DominikMat/String-Art-Robot-V2/raport/traffic-simulator-de-screen.png

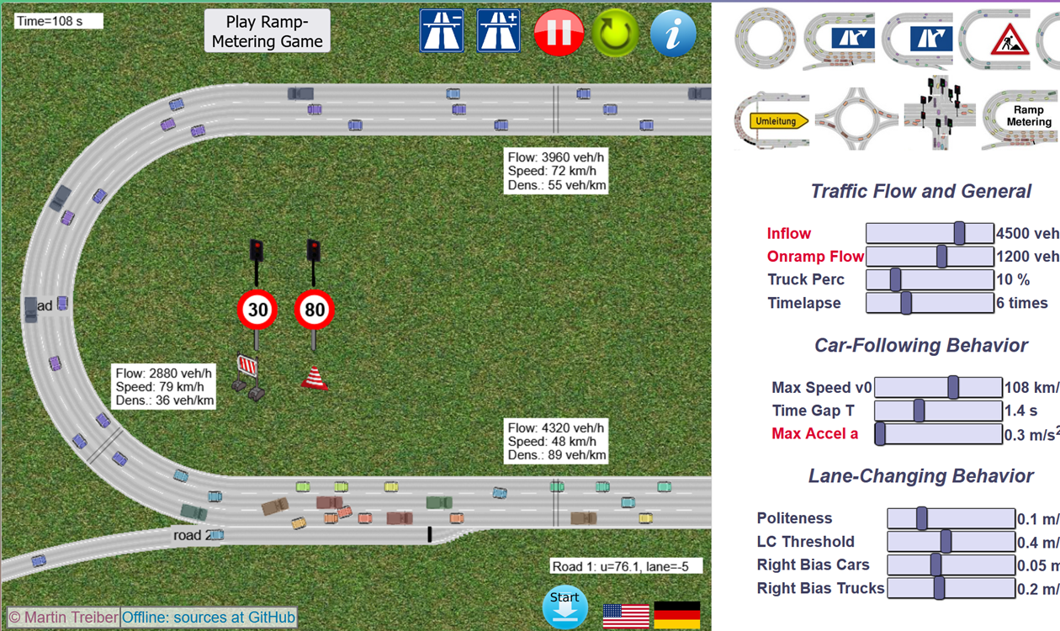
raport/traffic-simulator-de-screen.png
