DominikMat/String-Art-Robot-V2/raport/poczatkowe_szkice.jpg

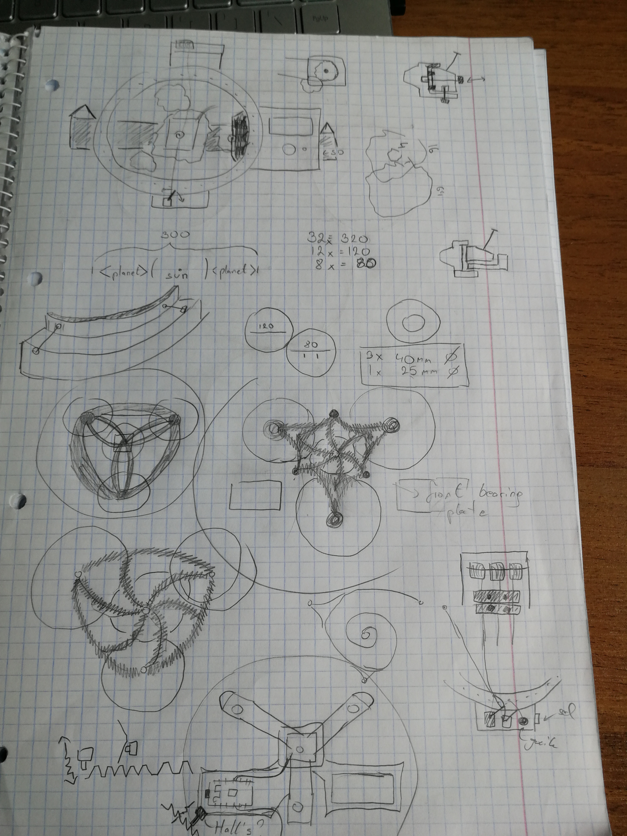
raport/poczatkowe_szkice.jpg
