DominikMat/String-Art-Robot-V2/raport/cad_przekladnia.png

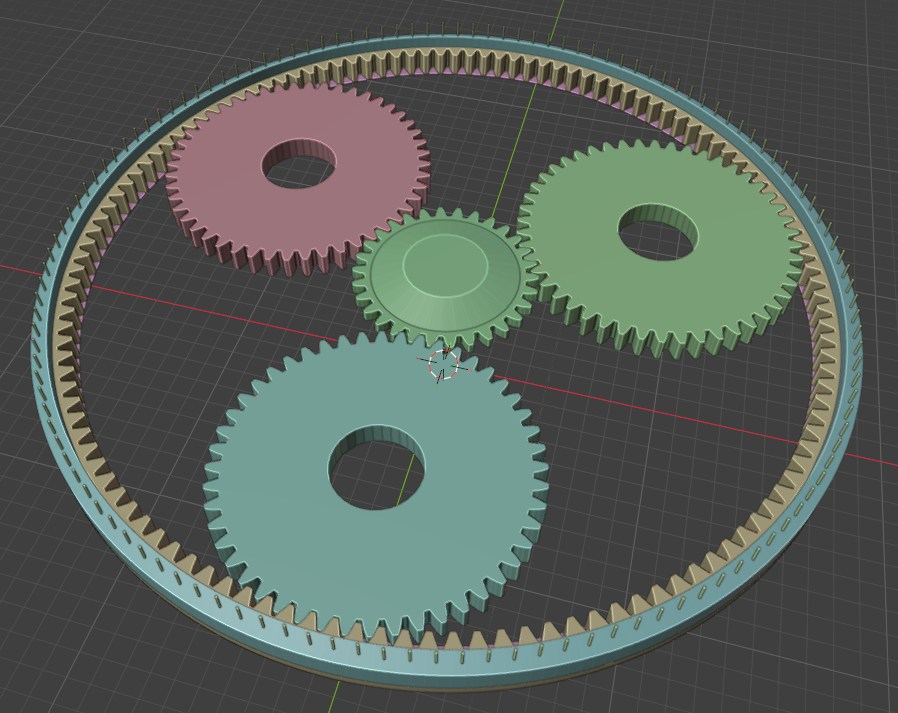
raport/cad_przekladnia.png
