DominikMat/String-Art-Robot-V2/raport/cura_screen_1.png

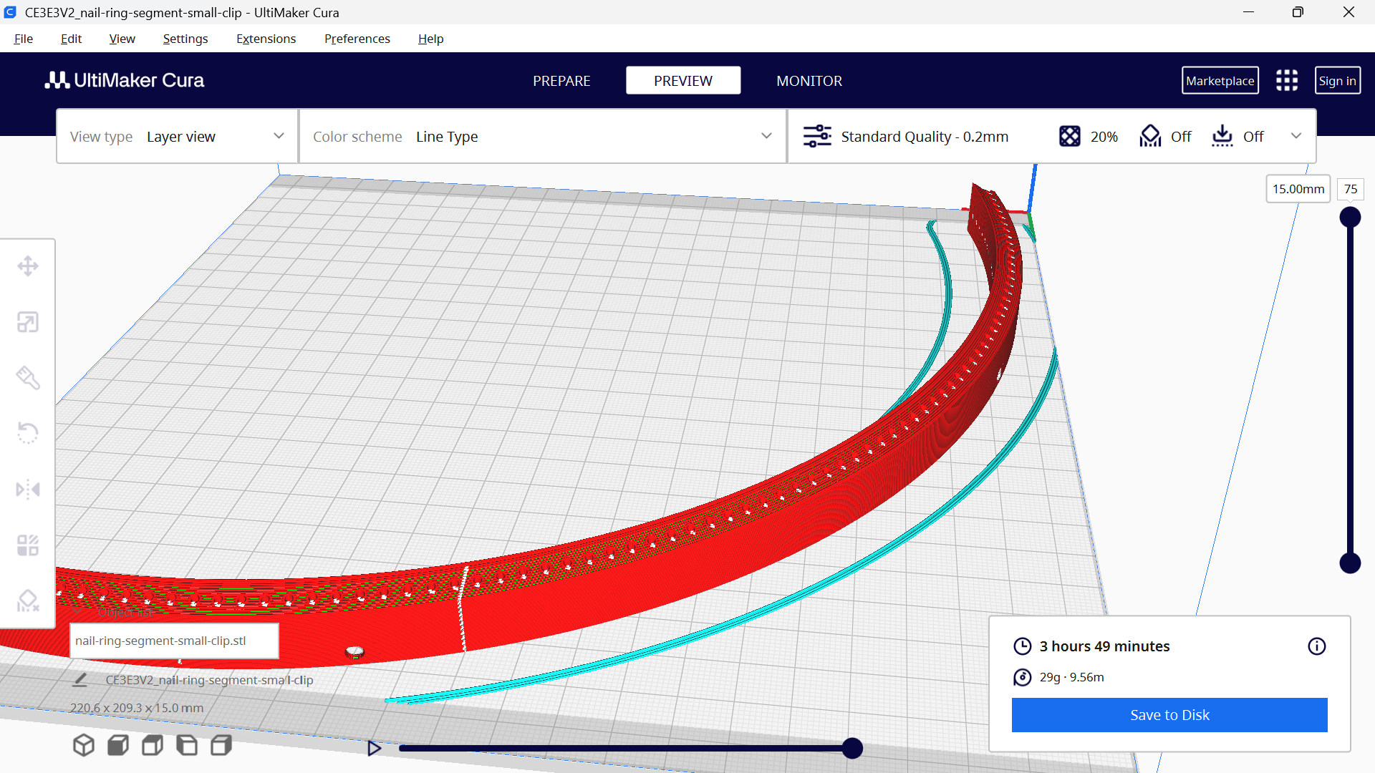
raport/cura_screen_1.png
