DominikMat/String-Art-Robot-V2/raport/dokumentacja_nema.png

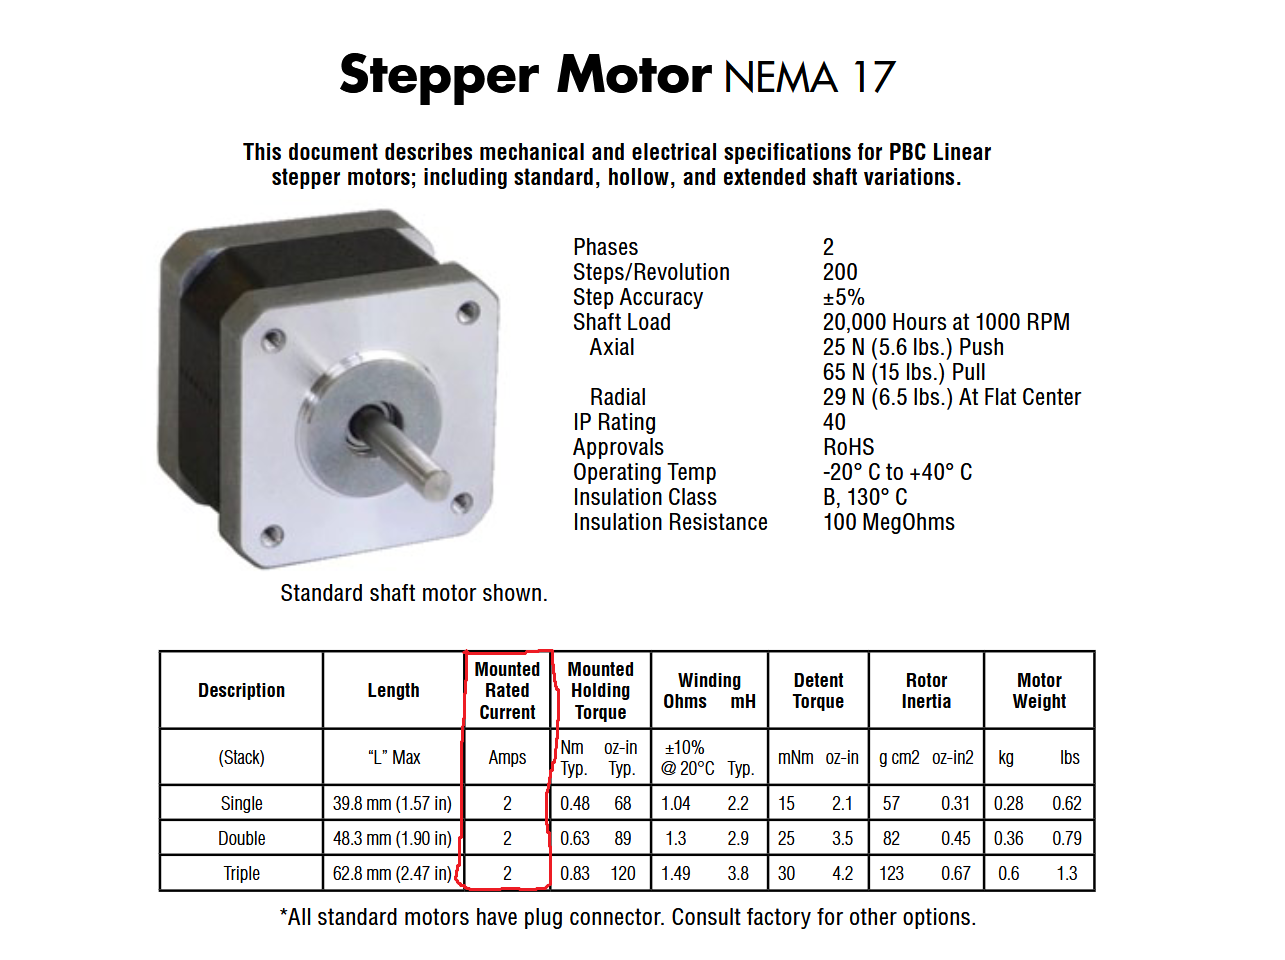
raport/dokumentacja_nema.png
