DominikMat/String-Art-Robot-V2/raport/pattern.png

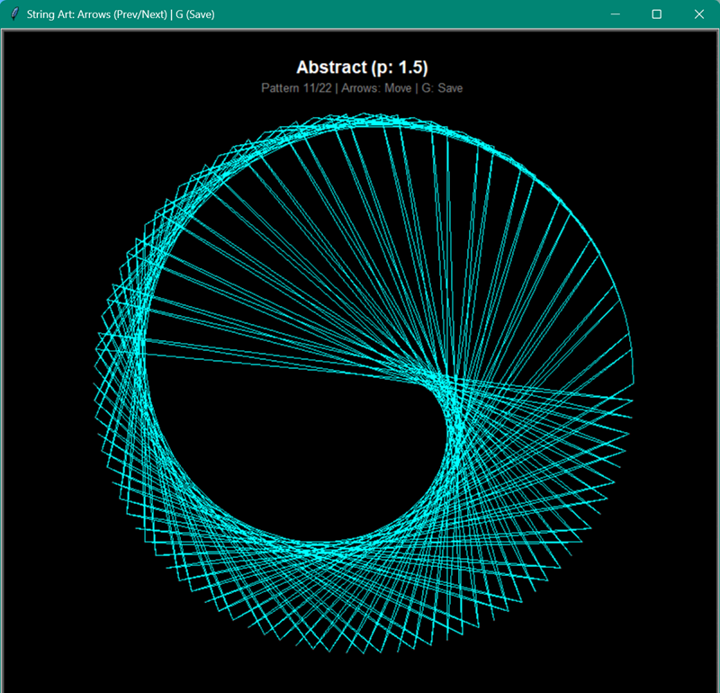
raport/pattern.png
