DominikMat/String-Art-Robot-V2/raport/schemat_ele.png

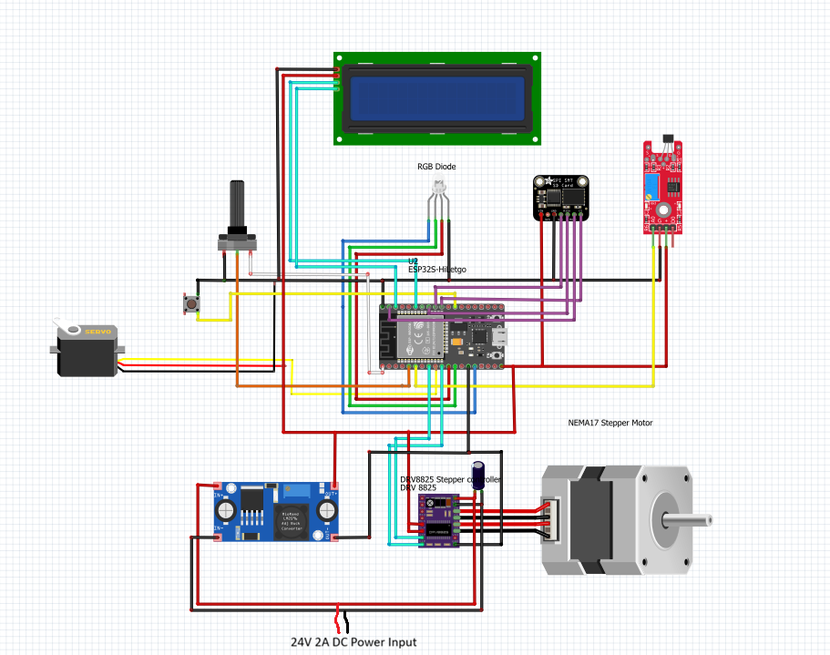
raport/schemat_ele.png
