DominikMat/String-Art-Robot-V2/raport/schemat_przekladnia.png

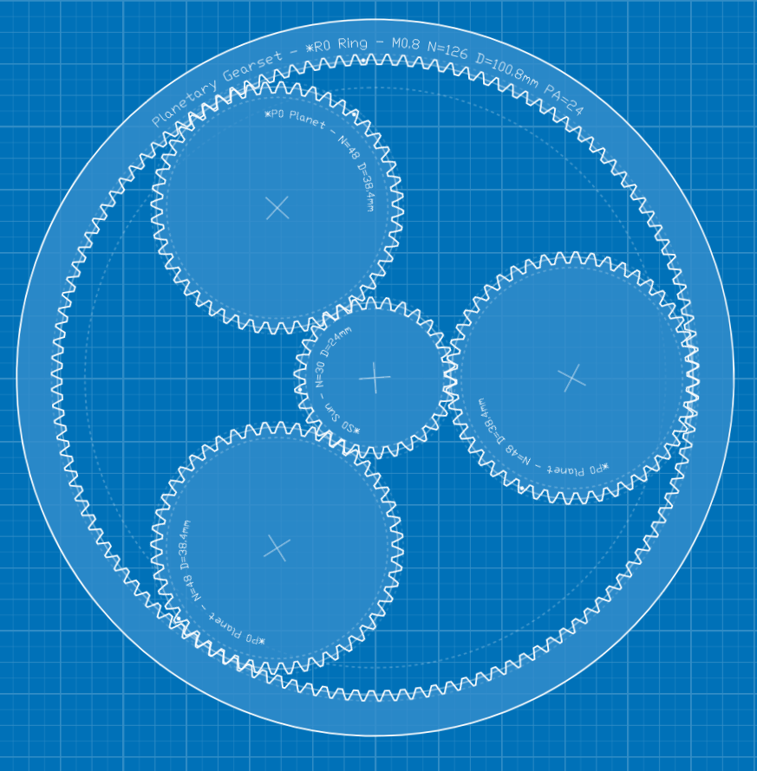
raport/schemat_przekladnia.png
