DominikMat/String-Art-Robot-V2/string_art_robot_pins.png

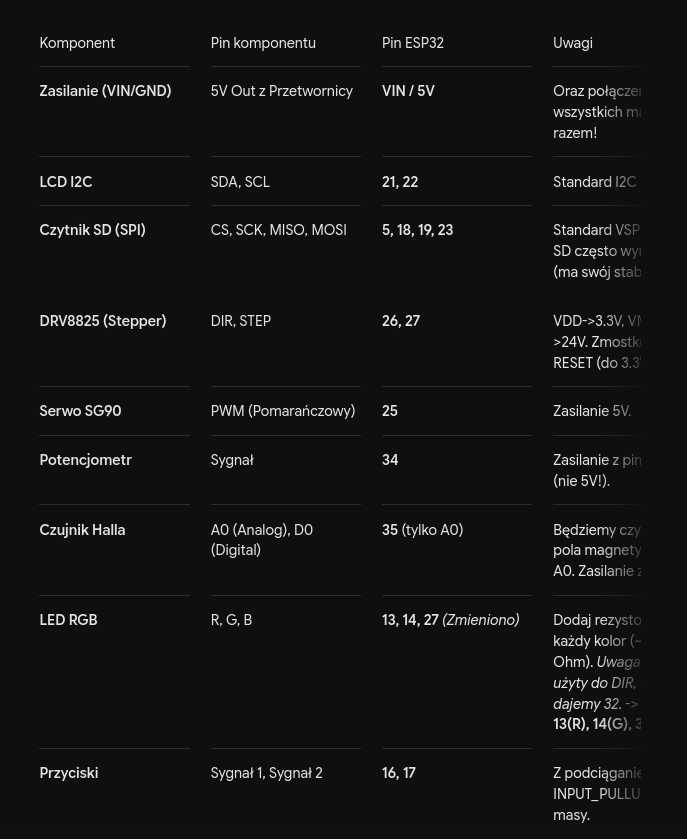
string_art_robot_pins.png
