DominikMat/String-Art-Robot-V2/3d print files/servo-arm.3mf

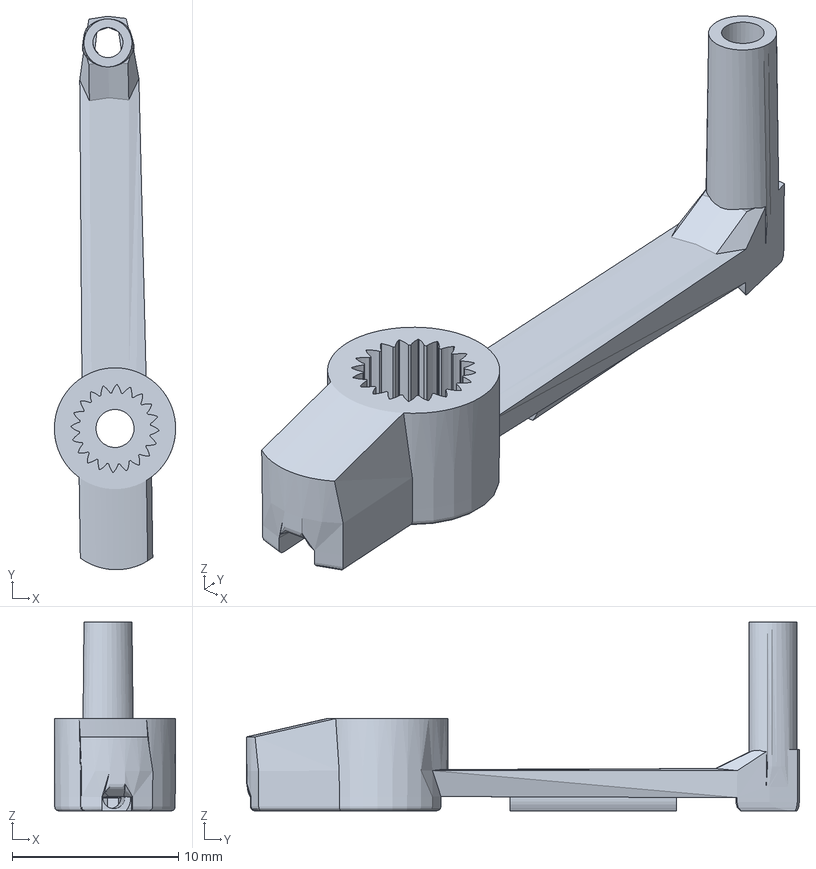
[picture p16: CAD file, 2026-05-09]
3d print files/servo-arm.3mf
7.29 x 33.3 x 11.4 mm
