DominikMat/String-Art-Robot-V2/3d prints V3/external-spool-holder.stl

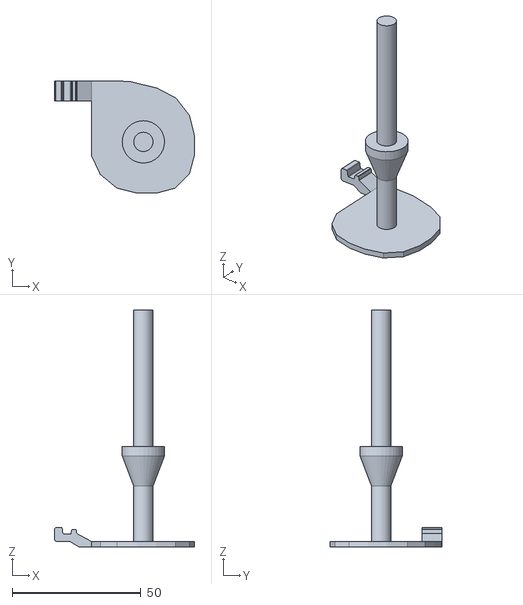
[picture p17: CAD file, 2026-06-16]
3d prints V3/external-spool-holder.stl
54.4 x 43.7 x 92.0
