DominikMat/String-Art-Robot-V2/3d print files/ring-holder-arm-upper.stl

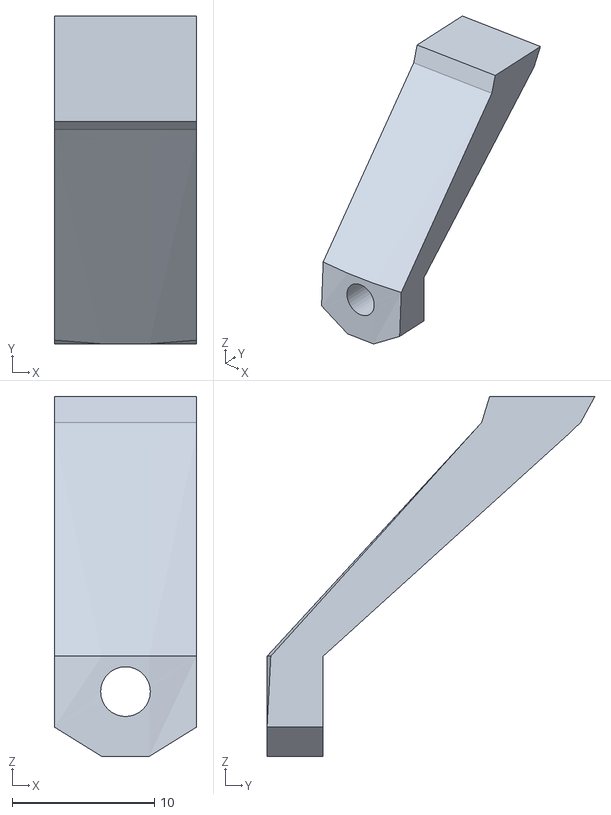
[picture p18: CAD file, 2026-05-09]
3d print files/ring-holder-arm-upper.stl
10.0 x 23.1 x 25.3
