DominikMat/String-Art-Robot-V2/3d prints V3/string-lock.stl

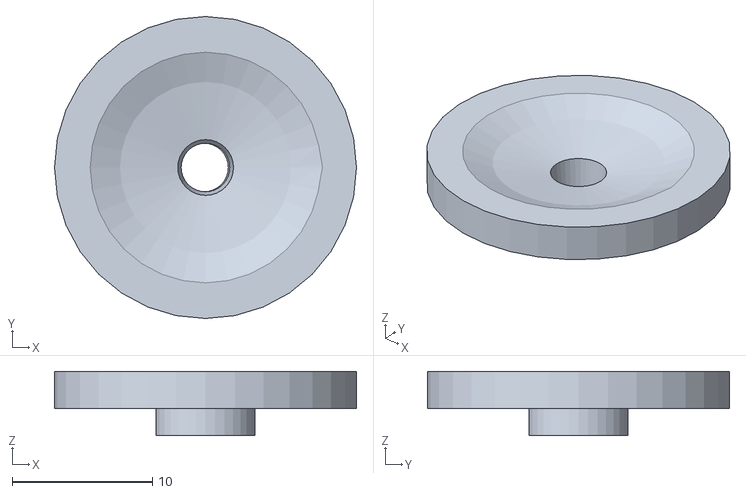
[picture p19: CAD file, 2026-06-10]
3d prints V3/string-lock.stl
21.5 x 21.5 x 4.59
