DominikMat/String-Art-Robot-V2/3d print files/planet-gear-1.stl

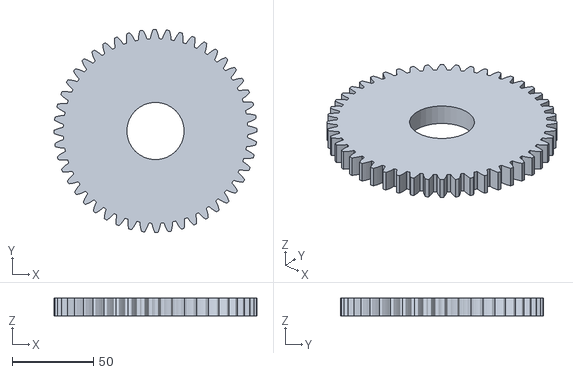
[picture p20: CAD file, 2026-05-09]
3d print files/planet-gear-1.stl
125.0 x 125.0 x 11.0
