DominikMat/String-Art-Robot-V2/3d prints V3/ring-mechanism.3mf

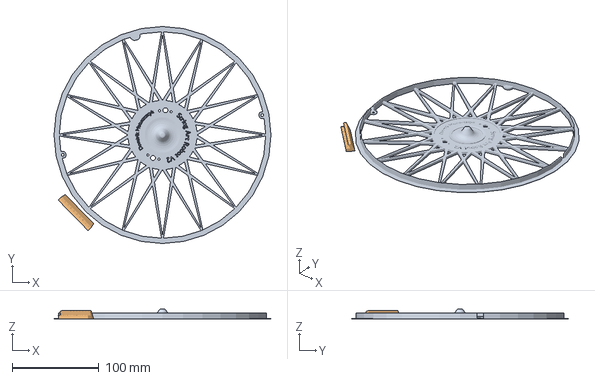
[picture p21: CAD file, 2026-06-10]
3d prints V3/ring-mechanism.3mf
250.0 x 250.0 x 12.0 mm
ring-mechanism.stl
ring-test.stl
