DominikMat/String-Art-Robot-V2/3d print files/nail-ring-segment-small-clip.stl

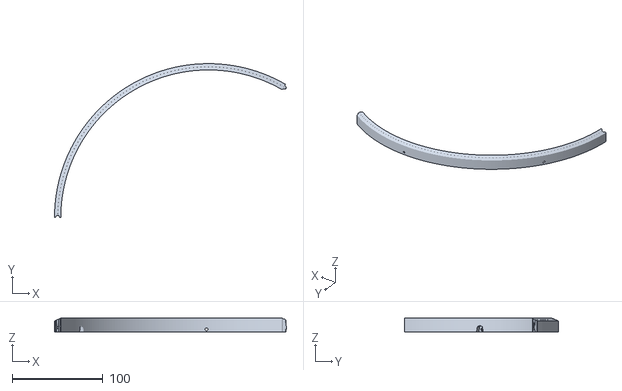
[picture p22: CAD file, 2026-05-09]
3d print files/nail-ring-segment-small-clip.stl
256.2 x 169.8 x 15.0
