DominikMat/String-Art-Robot-V2/3d prints V3/nail-ring.3mf

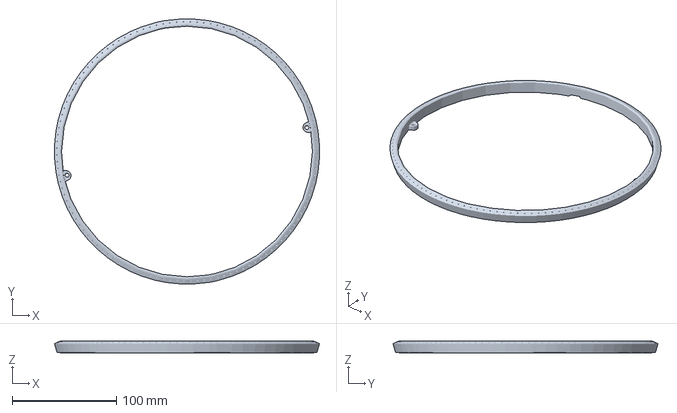
[picture p23: CAD file, 2026-06-10]
3d prints V3/nail-ring.3mf
253.9 x 253.9 x 11.1 mm
