DominikMat/String-Art-Robot-V2/3d print files/ring-holder-arm-lower.stl

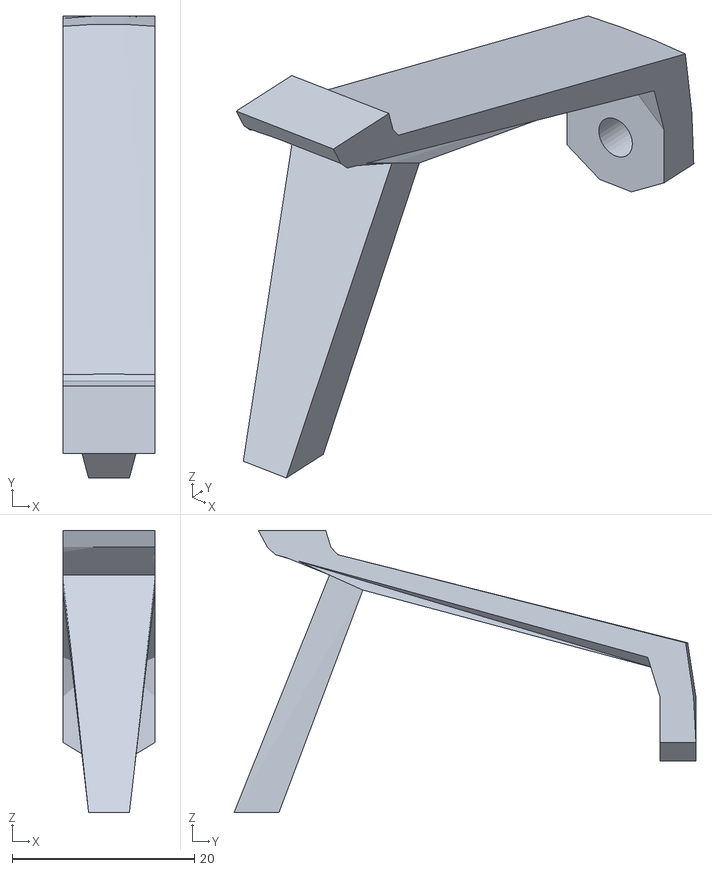
[picture p24: CAD file, 2026-05-09]
3d print files/ring-holder-arm-lower.stl
10.1 x 50.7 x 31.0
