DominikMat/String-Art-Robot-V2/3d prints V3/long-button-cap.3mf

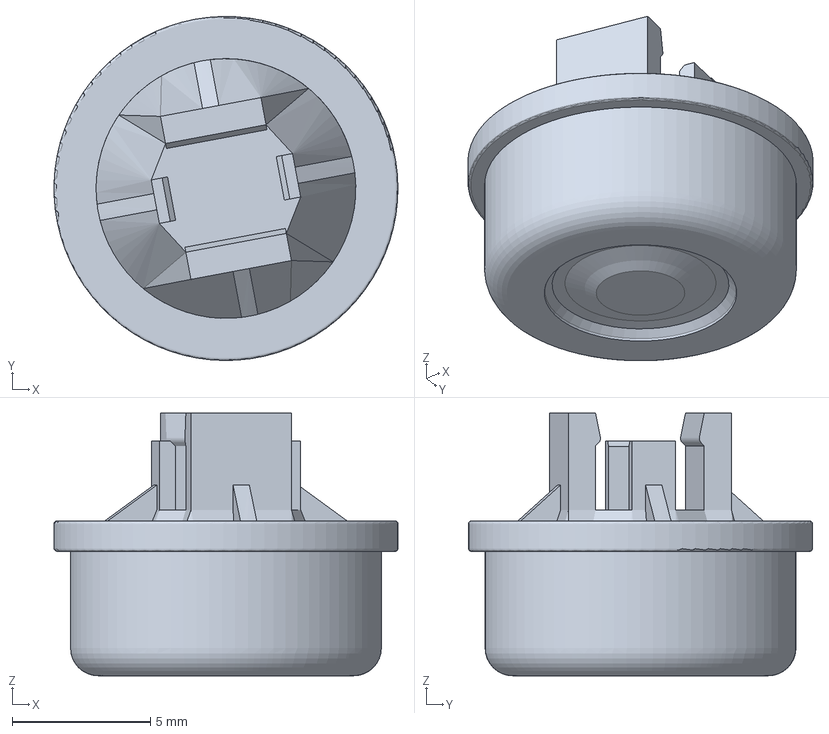
[picture p25: CAD file, 2026-06-10]
3d prints V3/long-button-cap.3mf
12.4 x 12.4 x 9.50 mm
