DominikMat/String-Art-Robot-V2/3d print files/front-plate.stl

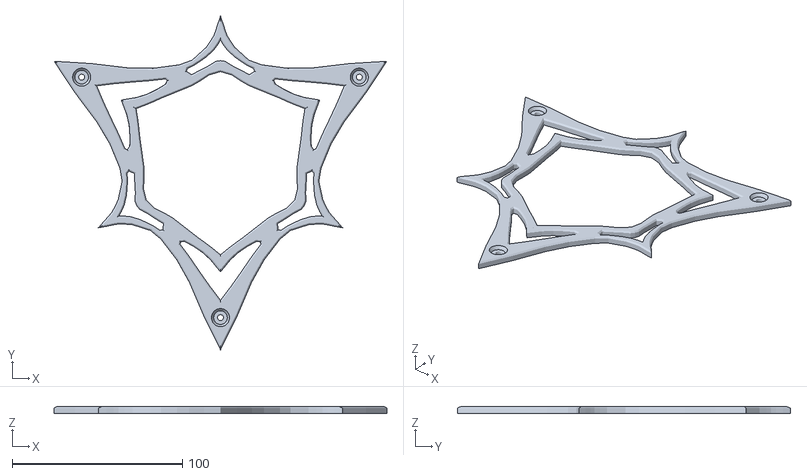
[picture p26: CAD file, 2026-05-09]
3d print files/front-plate.stl
195.7 x 195.8 x 4.00
