DominikMat/String-Art-Robot-V2/3d prints V3/servo-arm-2.3mf

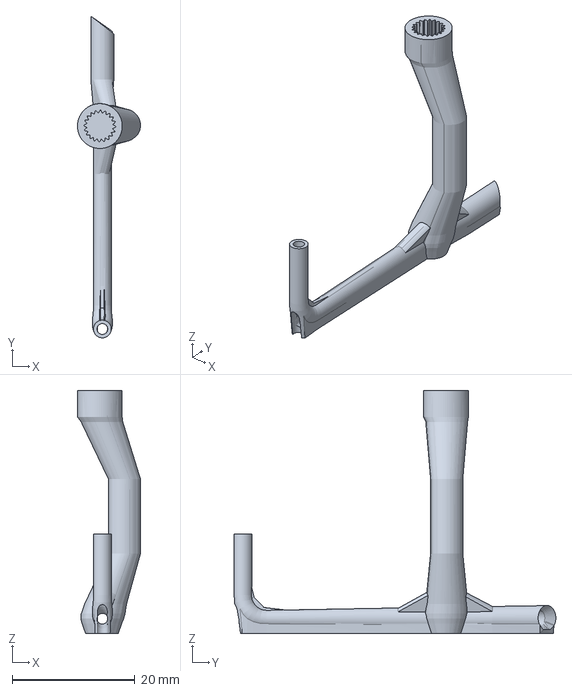
[picture p27: CAD file, 2026-06-10]
3d prints V3/servo-arm-2.3mf
10.3 x 52.4 x 39.6 mm
