DominikMat/String-Art-Robot-V2/3d print files/nail-test-piece.3mf

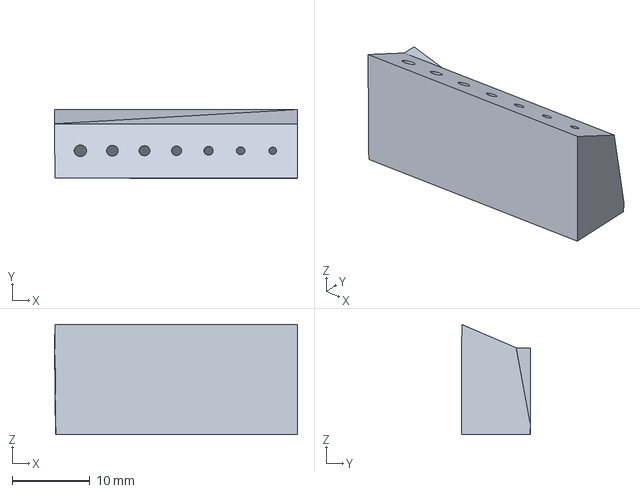
[picture p28: CAD file, 2026-05-09]
3d print files/nail-test-piece.3mf
31.3 x 8.91 x 14.2 mm
