DominikMat/String-Art-Robot-V2/3d prints V3/servo-arm.3mf

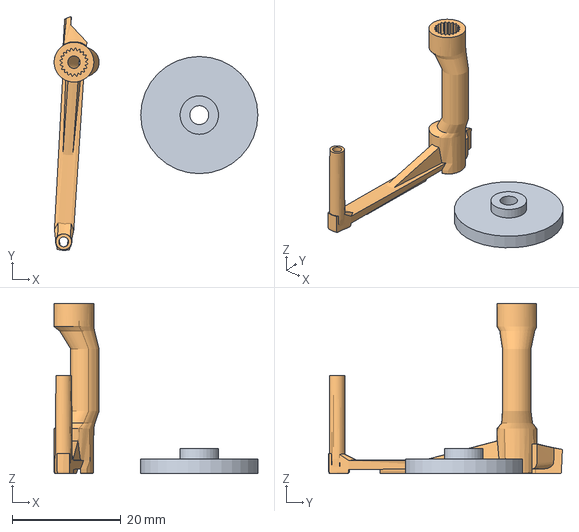
[picture p29: CAD file, 2026-06-10]
3d prints V3/servo-arm.3mf
37.5 x 43.0 x 31.3 mm
string-lock.stl
servo-arm.stl
