DominikMat/String-Art-Robot-V2/3d print files/sun-gear.stl

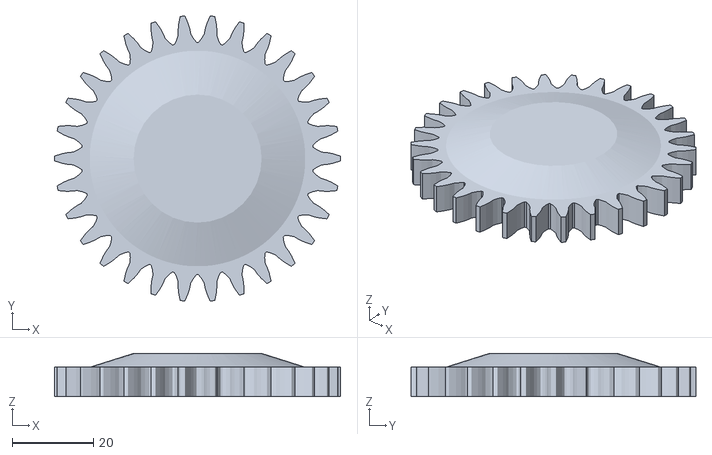
[picture p30: CAD file, 2026-05-09]
3d print files/sun-gear.stl
70.4 x 70.1 x 10.6
