DominikMat/String-Art-Robot-V2/3d prints V3/bottom-stand.3mf

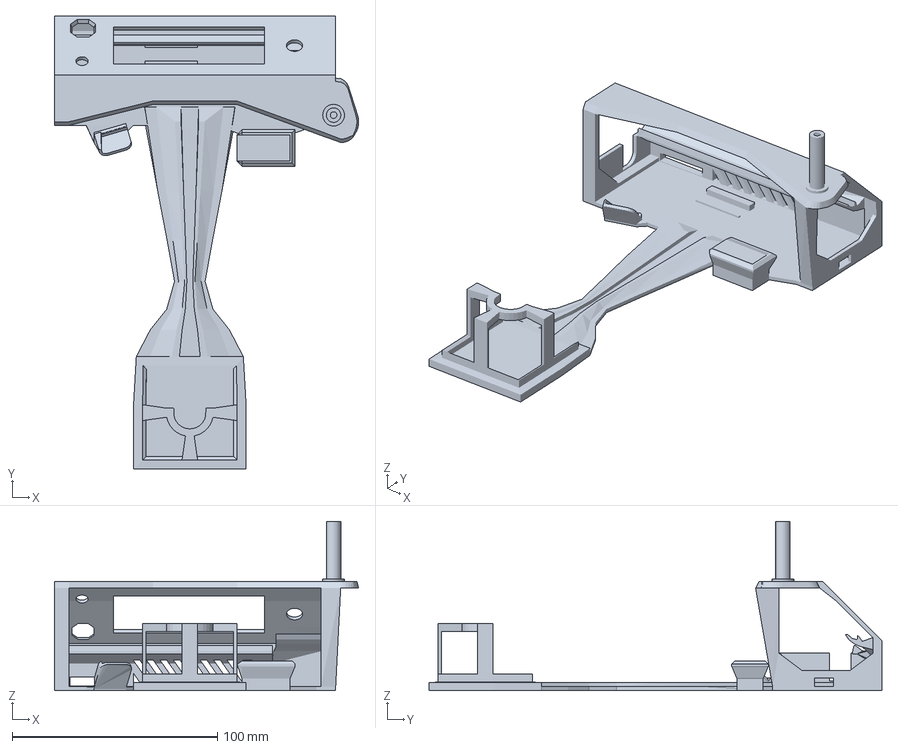
[picture p31: CAD file, 2026-06-10]
3d prints V3/bottom-stand.3mf
148.2 x 220.7 x 82.5 mm
