DominikMat/String-Art-Robot-V2/3d print files/nail-ring-segment.3mf

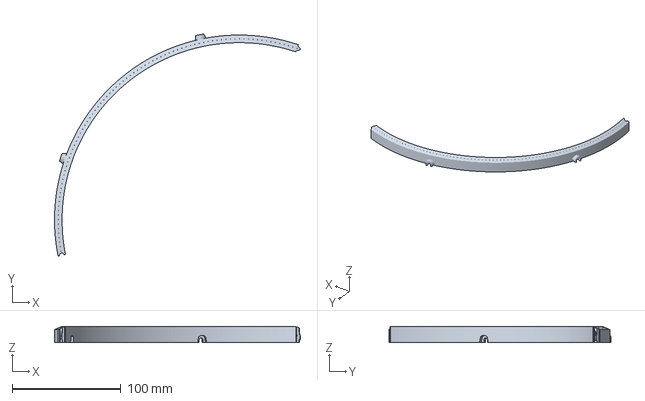
[picture p32: CAD file, 2026-05-09]
3d print files/nail-ring-segment.3mf
226.3 x 204.3 x 15.0 mm
