DominikMat/String-Art-Robot-V2/3d prints V3/ring-test.stl

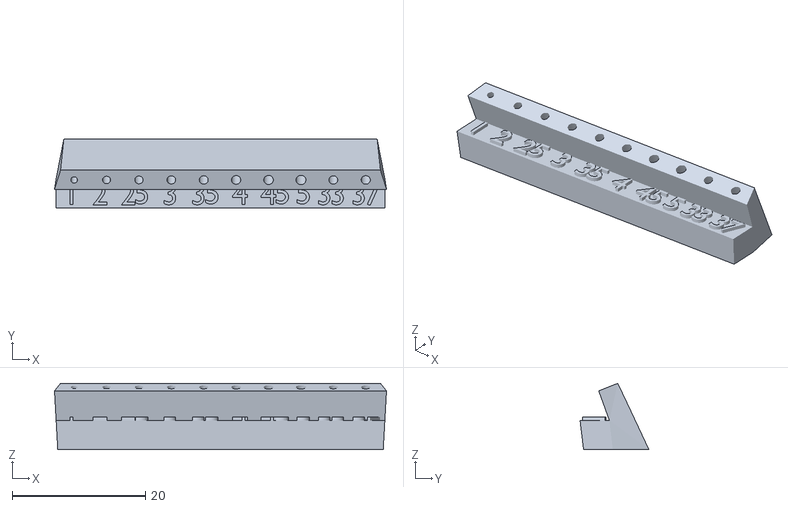
[picture p33: CAD file, 2026-06-10]
3d prints V3/ring-test.stl
49.7 x 10.3 x 9.93
