DominikMat/String-Art-Robot-V2/3d print files/hex-receptor-test-piece.stl

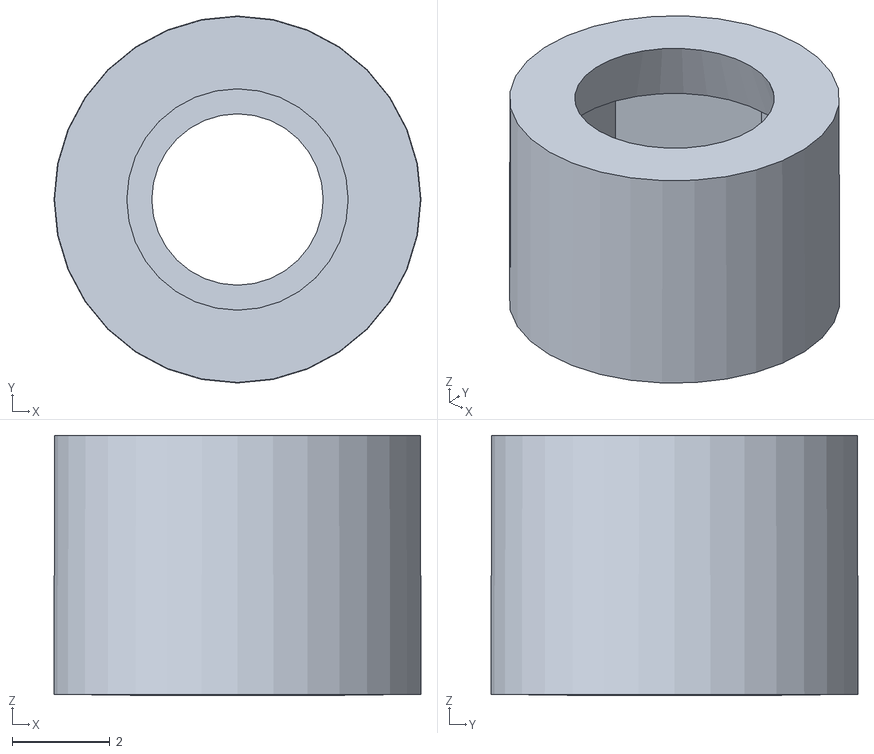
[picture p34: CAD file, 2026-05-09]
3d print files/hex-receptor-test-piece.stl
7.50 x 7.50 x 5.31
