DominikMat/String-Art-Robot-V2/3d prints V3/ring.3mf

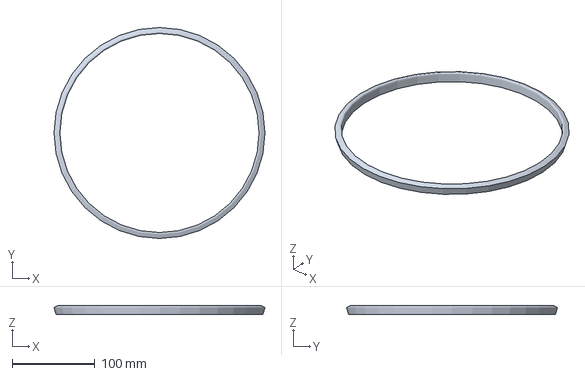
[picture p35: CAD file, 2026-06-10]
3d prints V3/ring.3mf
255.0 x 255.0 x 11.0 mm
