DominikMat/String-Art-Robot-V2/3d print files/ring-gear-segment.stl

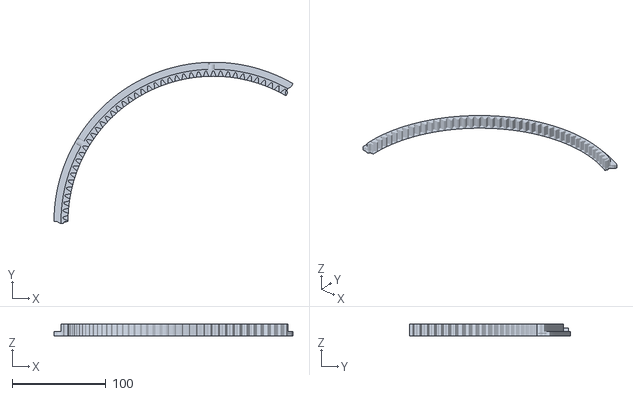
[picture p36: CAD file, 2026-05-09]
3d print files/ring-gear-segment.stl
255.0 x 172.3 x 12.5
