DominikMat/String-Art-Robot-V2/3d prints V3/string-art-robot-CAD.3mf

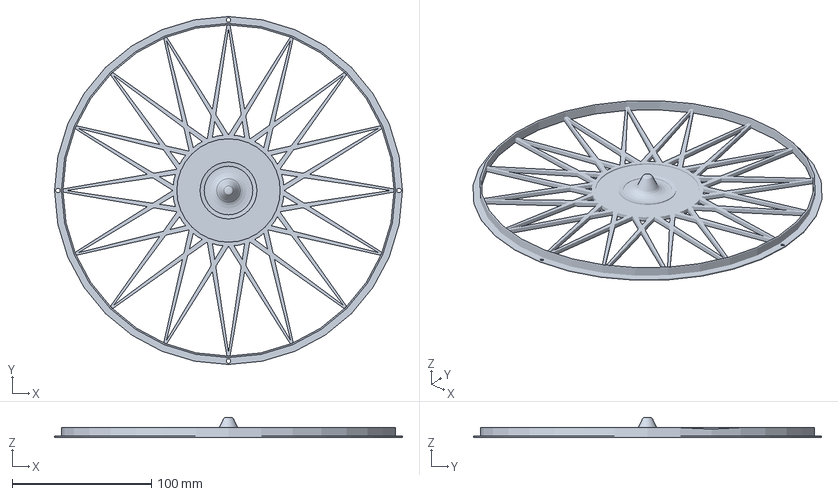
[picture p37: CAD file, 2026-05-20]
3d prints V3/string-art-robot-CAD.3mf
250.0 x 250.0 x 14.7 mm
