DominikMat/String-Art-Robot-V2/3d print files/planet-gear-skinny.3mf

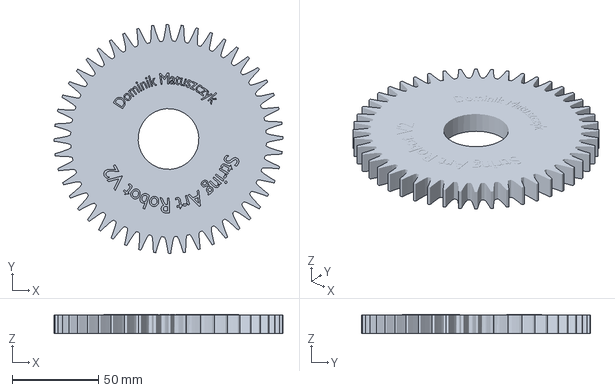
[picture p38: CAD file, 2026-05-09]
3d print files/planet-gear-skinny.3mf
133.0 x 133.0 x 11.1 mm
