DominikMat/String-Art-Robot-V2/3d print files/back-plate.stl

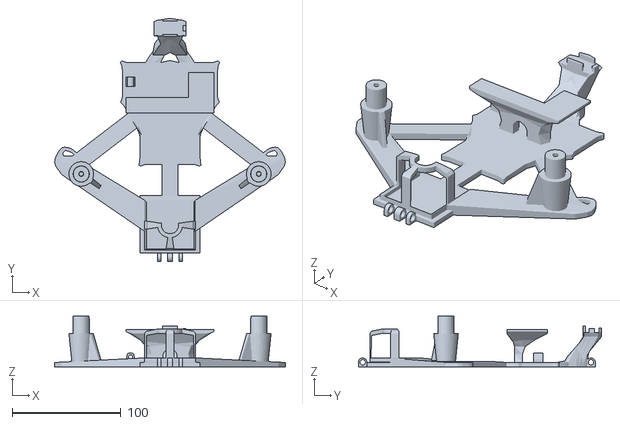
[picture p39: CAD file, 2026-05-09]
3d print files/back-plate.stl
212.4 x 223.7 x 46.6
