DominikMat/String-Art-Robot-V2/3d print files/bottom-gear-holder-arm.3mf

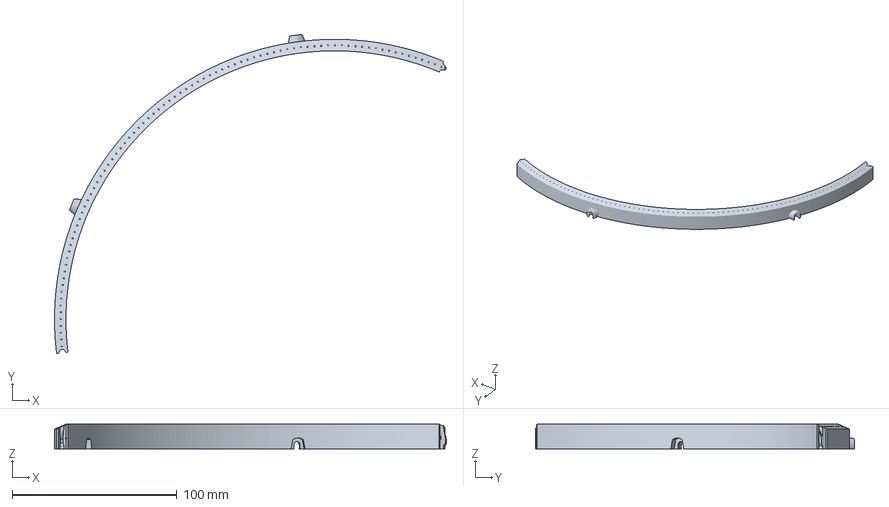
[picture p40: CAD file, 2026-05-09]
3d print files/bottom-gear-holder-arm.3mf
237.9 x 193.7 x 15.0 mm
