DominikMat/String-Art-Robot-V2/3d print files/gear-spacer.stl

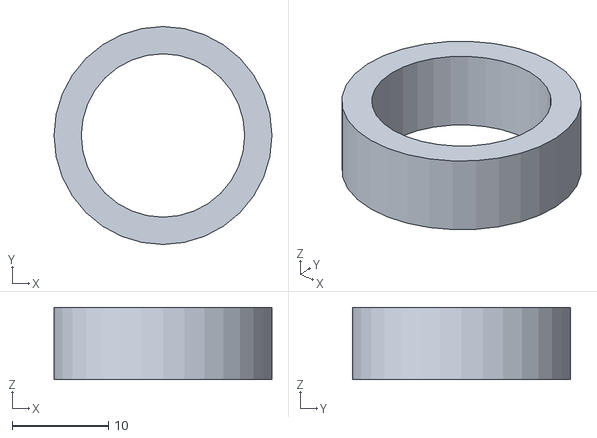
[picture p41: CAD file, 2026-05-09]
3d print files/gear-spacer.stl
22.7 x 22.7 x 7.50
