DominikMat/String-Art-Robot-V2/(list of files, cad)

Other CAD files:
3d print files/bottom-gear-holder-arm.stl
3d print files/nail-ring-segment.stl
3d print files/nail-test-piece.stl
3d print files/planet-gear-skinny.stl
3d print files/servo-arm.blend
3d print files/servo-arm.stl
3d print files/string-art-robot-CAD.blend
3d prints V3/bottom-stand.stl
3d prints V3/long-button-cap.stl
3d prints V3/nail-ring.stl
3d prints V3/ring-mechanism.stl
3d prints V3/ring.stl
3d prints V3/servo-arm-2.stl
3d prints V3/servo-arm.stl
3d prints V3/string-art-robot-CAD.blend
