DominikMat/String-Art-Robot-V2/(list of files, drawings)

Other design files:
schemat ele/schemat.fzz
