DominikMat/String-Art-Robot-V2/String Art Robot v2/src/components.cpp

#include "components.h"
#include "lcd_menu.h"
#include "threader.h"

// wlasne znaki do lcd
byte invLess[8] = { 0b11101, 0b11011, 0b10111, 0b01111, 0b10111, 0b11011, 0b11101, 0b11111 };
byte invDash[8] = { 0b11111, 0b11111, 0b11111, 0b00000, 0b11111, 0b11111, 0b11111, 0b11111 };
byte normalDot[8] = { 0b00000, 0b00000, 0b01110, 0b01110, 0b01110, 0b00000, 0b00000, 0b00000 };
byte invDot[8] = { 0b11111, 0b11111, 0b10001, 0b10001, 0b10001, 0b11111, 0b11111, 0b11111 };
byte pauseChar[8] = { 0b00000, 0b01010, 0b01010, 0b01010, 0b01010, 0b01010, 0b00000, 0b00000 };
byte invPauseChar[8] = { 0b11111, 0b10101, 0b10101, 0b10101, 0b10101, 0b10101, 0b11111, 0b11111 };

/* ====================================================================================================== */
/*                                              COMPONENTS                                                */
/* ====================================================================================================== */

/* LCD Display */
    #define I2C_SDA 21
    #define I2C_SCL 22
    LiquidCrystal_I2C lcd(0x27, 16, 2); 
    unsigned long lastDisplayUpdate = 0;
    
    void initLcd() {
        Wire.begin(I2C_SDA, I2C_SCL);
        lcd.init();
        lcd.backlight();

        lcd.createChar(CHAR_INVERTED_LESS, invLess);
        lcd.createChar(CHAR_INVERTED_DASH, invDash);
        lcd.createChar(CHAR_DOT, normalDot);
        lcd.createChar(CHAR_INVERTED_DOT, invDot);
        lcd.createChar(CHAR_PAUSE, pauseChar);
        lcd.createChar(CHAR_INVERTED_PAUSE, invPauseChar);
        
        lcd.setCursor(0, 0);
        lcd.print("String art robot");
        lcd.setCursor(0, 1);
        lcd.print("V2 - Dominik Mat");
    }
    
/* Servo */
    #define SERVO_PIN 25
    bool servoIsLeft = true;
    const int minimumPulseWidthUs = 500; // microseconds
    const int maximumPulseWidthUs = 2400; // microseconds
    
    #define USE_LIBRARY_PWM true

    #if USE_LIBRARY_PWM
        Servo libServo;
    #else
        int servoCurrentPulseWidth = (minimumPulseWidthUs+maximumPulseWidthUs)/2; // start at pos 0 (in middle)
    #endif

    void initServo() {
        #if USE_LIBRARY_PWM
            libServo.setPeriodHertz(50); // Standard 50Hz for SG90
            libServo.attach(SERVO_PIN, minimumPulseWidthUs, maximumPulseWidthUs); 
            libServo.write(SERVO_INSIDE_ANGLE); // default pos
        #else
            pinMode(SERVO_PIN, OUTPUT);
        #endif
    }
    void servoWrite(int angleDeg = 0) {
        #if USE_LIBRARY_PWM
            libServo.write(angleDeg);
        #else
            if (angleDeg < 0) angleDeg = 0; // clamp
            if (angleDeg > 180) angleDeg = 180; // clamp

            int neededPulse = (angleDeg * (maximumPulseWidthUs-minimumPulseWidthUs))/180 + minimumPulseWidthUs;
            servoCurrentPulseWidth = neededPulse;
        #endif
    }
    void loopServo() {
        #if USE_LIBRARY_PWM
            // handled in background
        #else
            digitalWrite(SERVO_PIN, HIGH);
            delayMicroseconds(servoCurrentPulseWidth);
            digitalWrite(SERVO_PIN, LOW);
            delayMicroseconds(20000 - servoCurrentPulseWidth);
        #endif
    }

/* Potentiometer */
    #define POTENTIONMETER_PIN 34
    #define POTENTIONMETER_MIN_VALUE 100
    #define POTENTIONMETER_MAX_VALUE 3600

    float potentiometerValue = 0; 

    void initPotentiometer() {
        pinMode(POTENTIONMETER_PIN, INPUT);
    }
    float readPotentiometer() {
        int currentAnaglogValue = analogRead(POTENTIONMETER_PIN);
        potentiometerValue = (float)(currentAnaglogValue-POTENTIONMETER_MIN_VALUE) / (float)(POTENTIONMETER_MAX_VALUE-POTENTIONMETER_MIN_VALUE);
        potentiometerValue  = max(0.0f, min(1.0f, 1.0f - potentiometerValue)); 
        return potentiometerValue;
    }   
    int readPotentiometerRaw() {
        return analogRead(POTENTIONMETER_PIN);
    }

/* Led */
    #define LED_R 13
    #define LED_G 14
    #define LED_B 32
    int colorState = 0; 
    
    void initLed() {
        pinMode(LED_R, OUTPUT);
        pinMode(LED_G, OUTPUT);
        pinMode(LED_B, OUTPUT);
        setRGBColor(0, 0, 0);
    }
    void setRGBColor(int r, int g, int b) {
        // Serial.printf("Setting rgb diode colour: RGB(%d,%d,%d)\n",r,g,b);
        analogWrite(LED_R, r);
        analogWrite(LED_G, g);
        analogWrite(LED_B, b);
    }
    void set_rgb_specified_colour(RGBColour colour) {
        switch (colour) {
            case COLOUR_PRINTING:       setRGBColor(0, 0, 65);   break; // Brak (PREV Niebieski - pracuje)
            case COLOUR_PRINT_COMPLETE: setRGBColor(0, 150, 0);   break; // Ciemniejszy zielony
            case COLOUR_PRINT_PAUSED:   setRGBColor(255, 100, 0); break; // Jasny pomarańczowy
            case COLOUR_PRINT_STOPPED:  setRGBColor(255, 20, 0);  break; // Czerwono-pomarańczowy
            case COLOUR_READY:          setRGBColor(0, 255, 255); break; // Cyjan - gotowy do wyboru
            case COLOUR_ERROR:          setRGBColor(255, 0, 0);   break; // Czysty czerwony
            case COLOUR_CLEAR:          setRGBColor(0, 0, 0);     break; // Wyłączony
            case COLOUR_ALERT:          setRGBColor(255, 0, 255);     break; // Wyłączony
            default:                    setRGBColor(0, 0, 0);     break;
        }
    }

/* Button */
    #define BUTTON_PIN 16
    volatile unsigned long lastButton1Press = 0;
    const int debounceDelay = 250;
    volatile bool isButtonPressed = false;

    void IRAM_ATTR handleButton1() {
        unsigned long interruptTime = millis();
        if (interruptTime - lastButton1Press > debounceDelay) { 
            isButtonPressed = true;
            lastButton1Press = interruptTime;
            Serial.println("button pressed!");
        }
    }
    void initButton() {
        pinMode(BUTTON_PIN, INPUT_PULLUP);
        attachInterrupt(digitalPinToInterrupt(BUTTON_PIN), handleButton1, FALLING);
    }   
    bool checkButtonPressed() {
        if (isButtonPressed) { isButtonPressed = false; return true; }
        else return false;
    }

/* SD Card Reader */
    #define SD_CS_PIN 5
    #define SD_SCK_PIN 18
    #define SD_MISO_PIN 19
    #define SD_MOSI_PIN 23
    bool sd_card_detected = false;

    void initSDReader() {
        Serial.print("Init SD Card ... ");
        if (!SD.begin(SD_CS_PIN)) {
            Serial.println("> SD card NOT detected.");
        } else {
            sd_card_detected = true;
            Serial.println("> SD card detected!");
        }
    }
    void attempt_detect_sd_card() {
        Serial.print("Attempting Detect SD card ... ");
        if (SD.begin(SD_CS_PIN)) {
          showAlert("new SD card" , "detected");
          Serial.println("> detected");  
          sd_card_detected = true;
        } 
        else sd_card_detected = false;
    }
    std::vector<std::string> readPrintableFileNames() {
        if (!sd_card_detected) attempt_detect_sd_card();

        std::vector<std::string> fileNames;
        File root = SD.open("/");
        if (!root) {
            Serial.println("Nie mozna otworzyc folderu glownego SD");
            sd_card_detected = false;
            return fileNames;
        }

        File file = root.openNextFile();
        while (file) {
            if (!file.isDirectory()) {
                String name = file.name();
                // Szukamy plików z rozszerzeniem .gcode
                if (name.endsWith(".gcode") || name.endsWith(".GCODE")) {
                    int dotIndex = name.lastIndexOf('.'); // usun rozszerzenie
                    String nameWithoutExt = name.substring(0, dotIndex);
                    if (nameWithoutExt.startsWith("/")) { // unsun wiodacy slash
                        nameWithoutExt = nameWithoutExt.substring(1);
                    }
                    fileNames.push_back(nameWithoutExt.c_str());
                }
            }
            file = root.openNextFile();
        }
        root.close();
        return fileNames;
    }
    PrintSequence generatePrintSequenceFromFile(std::string filename) {
        if (!sd_card_detected) attempt_detect_sd_card();

        PrintSequence seq;
        seq.print_name = filename;
        
        String fullPath = "/" + String(filename.c_str()) + ".gcode";
        File file = SD.open(fullPath);
        if (!file) return seq;

        bool inSequence = false;
        
        while (file.available()) {
            // Czytamy całą linię do znaku nowej linii, funkcja trim() usuwa białe znaki (np. \r)
            String line = file.readStringUntil('\n');
            line.trim(); 
            
            if (line.length() == 0) continue;

            if (line.startsWith("NAIL_NUMBER=")) {
                seq.nail_number = line.substring(12).toInt();
            } 
            else if (line.startsWith("SEQUENCE_LENGTH=")) {
                seq.sequence_length = line.substring(16).toInt();
            } 
            else if (line == "SEQUENCE_START") {
                inSequence = true;
            } 
            else if (line == "SEQUENCE_END") {
                inSequence = false;
            } 
            else if (inSequence) {
                seq.nail_sequence.push_back(line.toInt());
            }
        }
        file.close();
        return seq;
    }


/* Hall Sensor */
    #define HALL_INPUT_PIN 35
    int hallValue = 0;

    void initHallSensor() {
        pinMode(HALL_INPUT_PIN, INPUT);
    }
    int readHallSensor() {
        hallValue = analogRead(HALL_INPUT_PIN);
        return hallValue;
    }
    bool isHallActive() {
        return hallValue == 0;
    }

/* DRV Stepper Controller (AccelStepper) */
    #define DRV_STEP_PIN 27
    #define DRV_DIR_PIN 26
    #define DRV_ENABLE_PIN 4 // connected do bridged pines on DRV - RST and SLP
    #define DRV_M0_PIN 2
    #define DRV_M1_PIN 33

    // const int TARGET_STEPPER_RPM = 10;
    // const int STEP_DELAY_MICROSECONDS = (60 / TARGET_STEPPER_RPM) * 1000 * 1000 / 4096; 
    const float STEPPER_HOME_MOVEMENT_OFFSET = -2 * (1/8.0f); // 2 steps anti-clockwise
    const float STEPPER_HOME_POSITION_OFFSET = 0.62 * (1/8.0f) ; // tiny clockwise offset
    
    const int STEPS_PER_FULL_STEPPER_ROTATION = 100;
    const int DEFAULT_STEPPER_SPEED = STEPS_PER_FULL_STEPPER_ROTATION * 0.225; // steps per second
    MicrostepMode current_microstep_mode = MicrostepMode::STEP_MODE_EIGHTS;
    AccelStepper stepper(AccelStepper::DRIVER, DRV_STEP_PIN, DRV_DIR_PIN);

    void initStepper() {
        stepper.setMaxSpeed(STEPS_PER_FULL_STEPPER_ROTATION * 4);
        stepper.setAcceleration(500.0);

        pinMode(DRV_ENABLE_PIN, OUTPUT);
        pinMode(DRV_M0_PIN, OUTPUT);
        pinMode(DRV_M1_PIN, OUTPUT);

        digitalWrite(DRV_ENABLE_PIN, HIGH);
        change_microstepping_mode(current_microstep_mode);
    }

    void move_stepper_steps(float step_number, bool anti_clockwise, bool bypass_print_checks) {
        if (step_number <= 0) return;

        // Obliczamy cel relatywny
        int relative_move = round((float)(anti_clockwise ? step_number : -step_number) * (int)current_microstep_mode);  
        stepper.setMaxSpeed(DEFAULT_STEPPER_SPEED * (int)current_microstep_mode);
        stepper.move(relative_move);
        
        unsigned long last_watchdog_yield = millis();
        
        // petla na ruch silnika
        while (stepper.distanceToGo() != 0) {
            if (!bypass_print_checks) {
                if (!is_print_loaded()) {
                    stepper.stop(); 
                    return;
                }
                while (is_printing_paused() && is_print_loaded()) {
                    vTaskDelay(50 / portTICK_PERIOD_MS);
                }
            }

            stepper.run();
            
            // Oddanie czasu dla FreeRTOS (Watchdog), żeby nie resetowało ESP32
            if (millis() - last_watchdog_yield > 10) {
                taskYIELD();
                last_watchdog_yield = millis();
            }
        }

        // Aktualizacja pozycji w Threader.cpp
        float actual_move = relative_move / (float)(int)current_microstep_mode;
        change_current_ring_position(-actual_move);

        Serial.printf("Moved stepper with step number: %f (curr microstep mode: %d * 1/%d) out of %f \n", actual_move, relative_move, (int)current_microstep_mode, step_number);
    }

    void change_microstepping_mode(MicrostepMode microstep_mode) {
        current_microstep_mode = microstep_mode;
        
        switch (microstep_mode) {
            case STEP_MODE_FULL:
            digitalWrite(DRV_M0_PIN, LOW);
                digitalWrite(DRV_M1_PIN, LOW);
                break;
            case STEP_MODE_HALF:
                digitalWrite(DRV_M0_PIN, HIGH);
                digitalWrite(DRV_M1_PIN, LOW);
                break;
            case STEP_MODE_QUARTER:
                digitalWrite(DRV_M0_PIN, LOW);
                digitalWrite(DRV_M1_PIN, HIGH);
                break;
            case STEP_MODE_EIGHTS:
                digitalWrite(DRV_M0_PIN, HIGH);
                digitalWrite(DRV_M1_PIN, HIGH);
                break;
        }
        // Krótkie opóźnienie, aby sterownik ustabilizował prąd na cewkach po zmianie
        vTaskDelay(5 / portTICK_PERIOD_MS);
    }
    MicrostepMode get_current_microstep_mode() {
        return current_microstep_mode;
    }

    void find_stepper_home_position() {
        Serial.println("Rozpoczynam szukanie punktu ZERO (Homing)...");

        MicrostepMode curr_mode = get_current_microstep_mode();
        change_microstepping_mode(STEP_MODE_EIGHTS);
        float homing_speed = 200.0;
        stepper.setMaxSpeed(homing_speed);

        // Jeśli wystartowaliśmy dokładnie nad magnesem - zchodzmiy
        readHallSensor();
        if (isHallActive()) {
            stepper.setSpeed(-homing_speed); // Kręcimy w tył (CCW)
            while (isHallActive()) {
                stepper.runSpeed();
                readHallSensor(); 
                taskYIELD();
            }
            stepper.move(-100);
            while (stepper.distanceToGo() != 0) { stepper.run(); taskYIELD(); }
        }

        stepper.setSpeed(homing_speed); // Kręcimy w przód (CW)
        while (!isHallActive()) {
            stepper.runSpeed();
            readHallSensor();
            taskYIELD();
        }
        long edge1 = stepper.currentPosition();
        //Serial.printf("Krawędź 1 znaleziona na kroku: %ld\n", edge1);

        while (isHallActive()) {
            stepper.runSpeed();
            readHallSensor();
            taskYIELD();
        }
        long edge2 = stepper.currentPosition();
        //Serial.printf("Krawędź 2 znaleziona na kroku: %ld\n", edge2);

        long center_position = (edge1 + edge2) / 2;
        //Serial.printf("Idealny środek obliczony na krok: %ld\n", center_position);

        stepper.moveTo(center_position);
        stepper.setMaxSpeed(400.0);
        stepper.setAcceleration(200.0); // Włączamy akcelerację dla płynnego powrotu
        
        while (stepper.distanceToGo() != 0) {
            stepper.run();
            taskYIELD();
        }

        // set 0 position after applying offset
        move_stepper_steps(abs(STEPPER_HOME_MOVEMENT_OFFSET), STEPPER_HOME_MOVEMENT_OFFSET < 0, true);
        // stepper.setCurrentPosition(-STEPPER_HOME_POSITION_OFFSET);
        set_current_ring_position(STEPPER_HOME_POSITION_OFFSET); // Synchronizujemy z zewnętrznym licznikiem w Threaderze

        change_microstepping_mode(curr_mode); // ustaw poprzedni tryb microstepping        
        Serial.println("Homing zakończony sukcesem!");
    }
