DominikMat/String-Art-Robot-V2/(commit log)

2026-05-10 working lcd menu, print sequencing with play/pause/stop functions, credits display, seperate printing thread
2026-05-11 generacja wzorow w gcode (python)
    [string-art-robot-CAD.blend]
2026-05-20 nowy 3d model design
    [ring-mechanism.stl, ring.stl, string-art-robot-CAD.3mf, string-art-robot-CAD.blend]
2026-06-10 aurea laptop code update
    [bottom-stand.3mf, bottom-stand.stl, long-button-cap.3mf, long-button-cap.stl, nail-ring.3mf, nail-ring.stl, ring-mechanism.3mf, ring-mechanism.stl]
2026-06-10 lcd component menu with test seqs
    [ring.3mf]
2026-06-16 koncowe poprawki logiki
    [external-spool-holder.stl, nail-ring.stl]
